Wanarut/Dust_IO/image/184261771_143745554332713_2939920048003660011_n.jpg

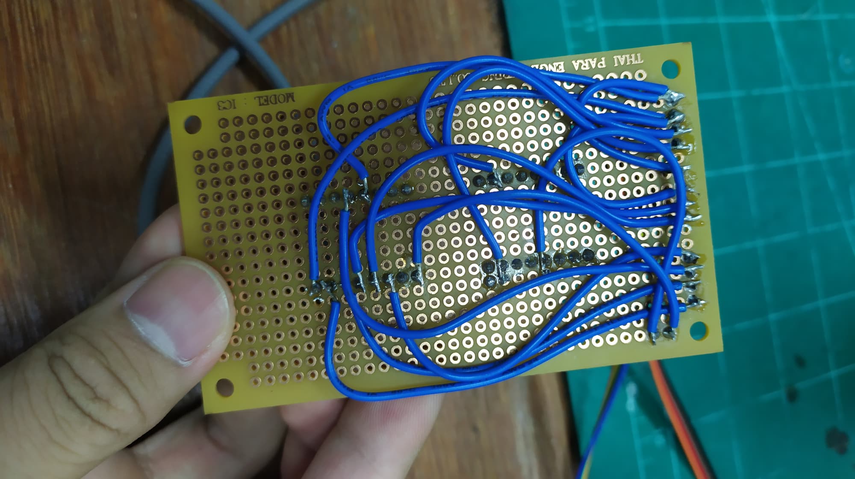
image/184261771_143745554332713_2939920048003660011_n.jpg
