Wanarut/Dust_IO/image/184985335_159320562802014_2121507055169097762_n.jpg

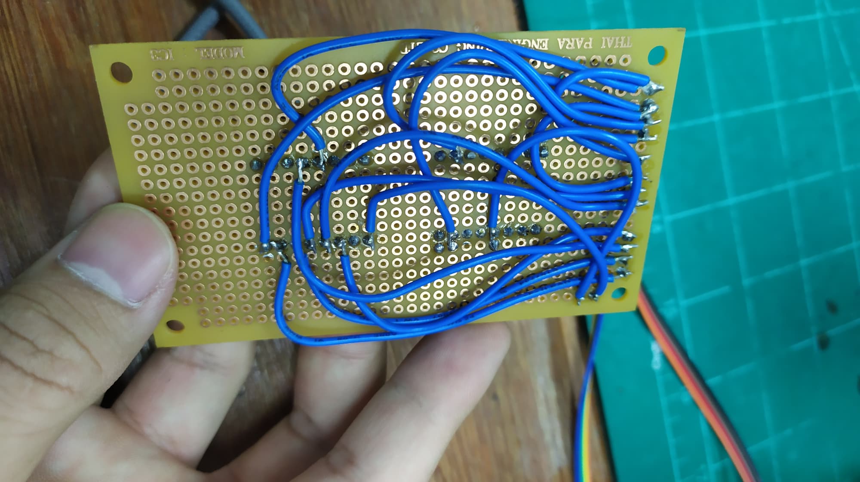
image/184985335_159320562802014_2121507055169097762_n.jpg
