Wanarut/Dust_IO/Screen.pdf

# Screen

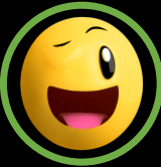
[picture p3: figure]

MODE AUTO H Filter 9 % | 25oc | RH 75%

## PM2.5 12 μg/m3

หน้าหลัก
- วงสีเขียวและอิโมจิเปลี่ยนตามค่าฝุ่ นตาม Slide 8
- ไฟแดงแสดงเมื่อ Filter < 10 %แ

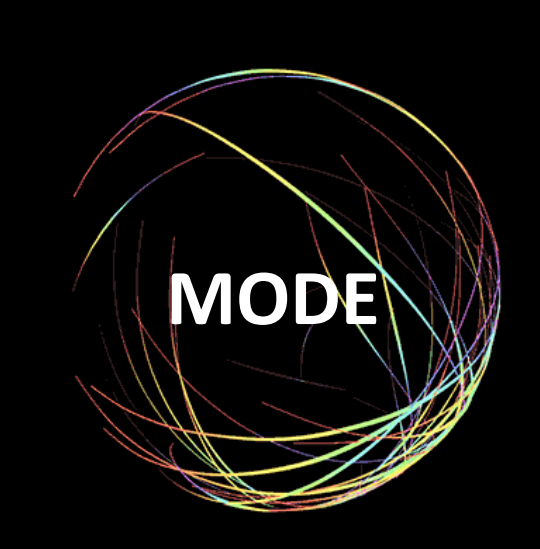
[picture p4: figure]
MODE
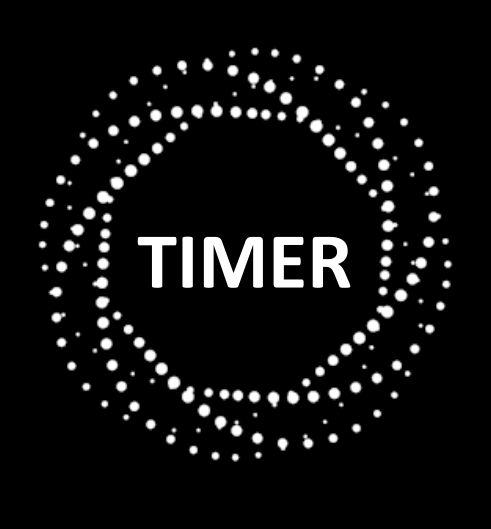
[picture p5: figure]
TIMER

- แตะหน้าหลัก เพื่อเข้าหน้าเลือก MODE,TIMER
- ทุกหน้าหากไม่มีการสั่งการ 15 sec จะกลับไปหน้าหลักอัตโนมัติ

# Screen

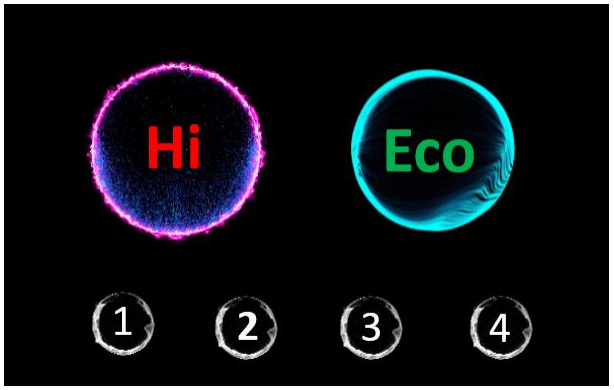
[picture p6: figure]

หน้า MODE
- Hi โหมดเดินเครื่องเต็มก าลังอัตโนมัติ
- eCo โหมดเดินเครื่องเสียงเบาอัตโนมัติ + ประหยัดไฟ
- 1, 2, 3, 4 โหมดปรับความเร็วลมได้ 4 ระดับ

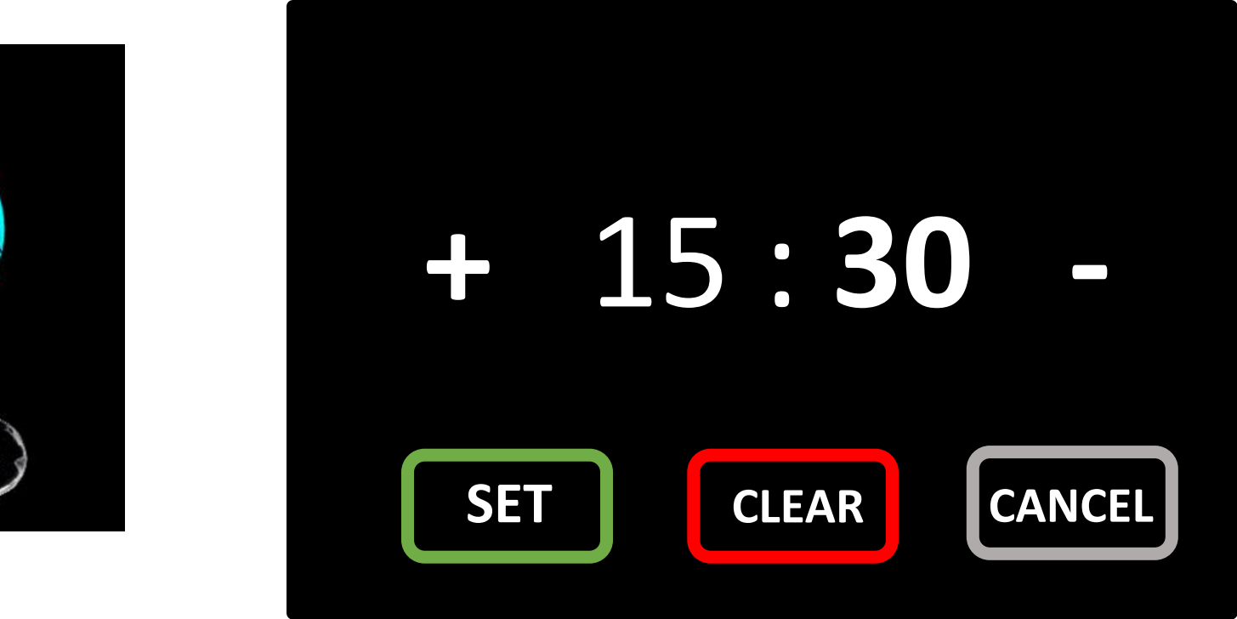
[picture p7: figure]
SET; CLEAR; CANCEL 4

หน้า TIMER
- ตั้งเวลา + , - ครั้งละ 30 min
- SET ตั้งค่าใหม่, CLEAR ลบการตั้งค่าทั้งหมด, CANCLE กลับไปหน้าหลัก

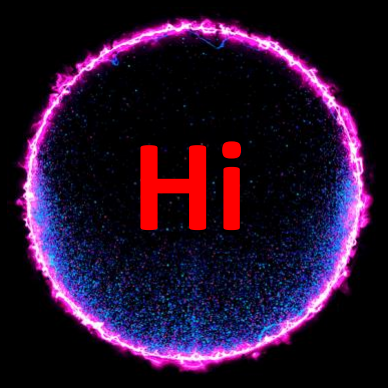
[picture p8: figure]
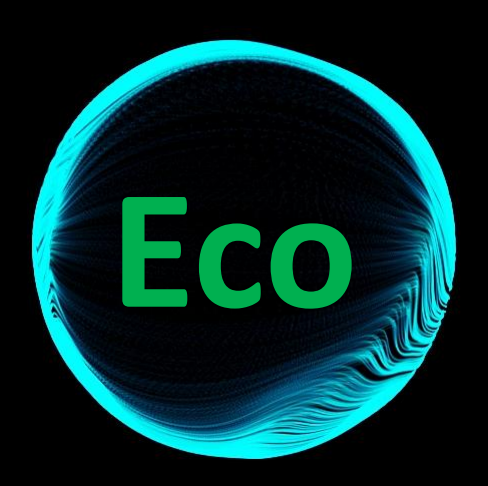
[picture p9: figure]

1 | 2 | 3 | 4
Hi | Eco

# Screen

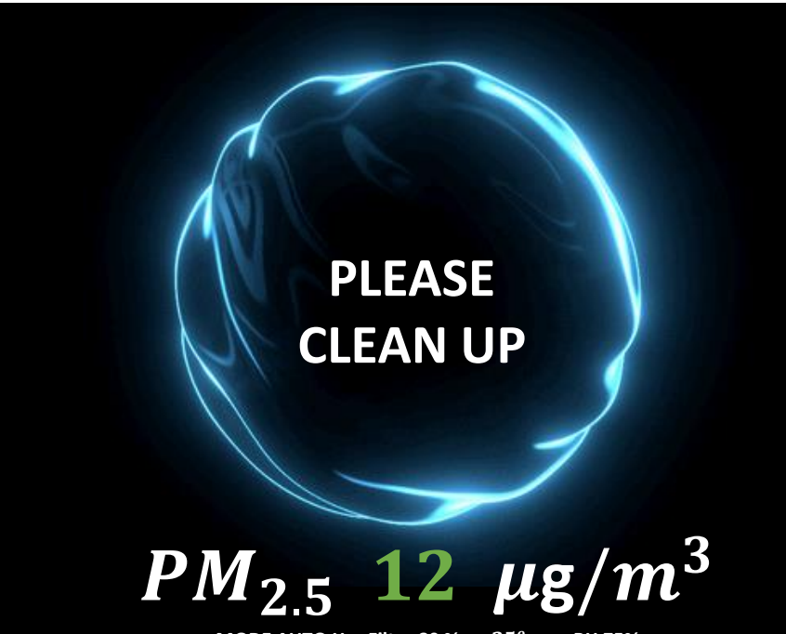
[picture p10: figure]
PLEASE CLEAN UP

หน้าแจ้งเตือนท าความสะอาด ESP

MODE AUTO H Filter 80 % | 25oc | RH 75%

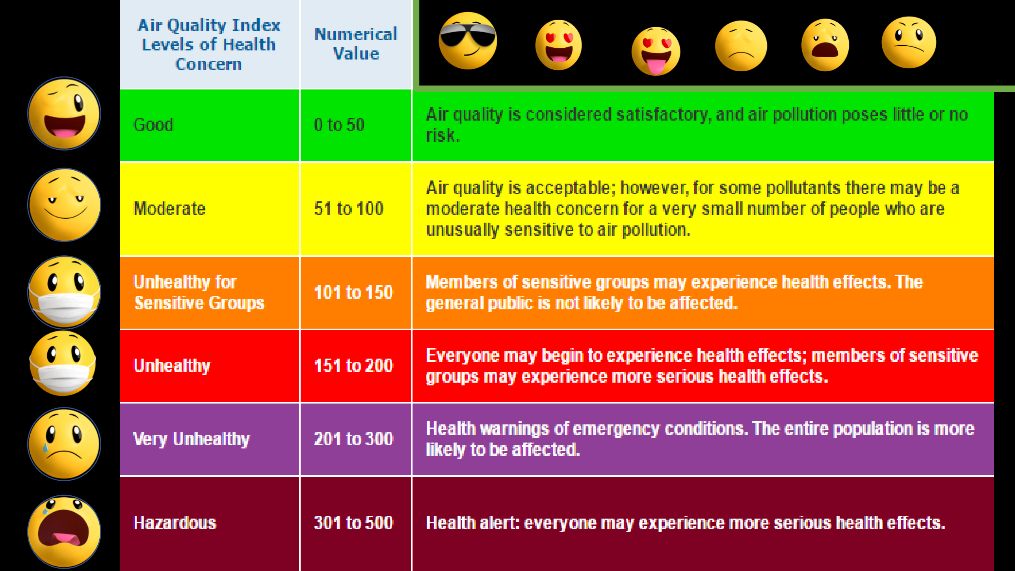
[picture p11: page 5]
