Wanarut/Dust_IO/DustUI/data/1.png

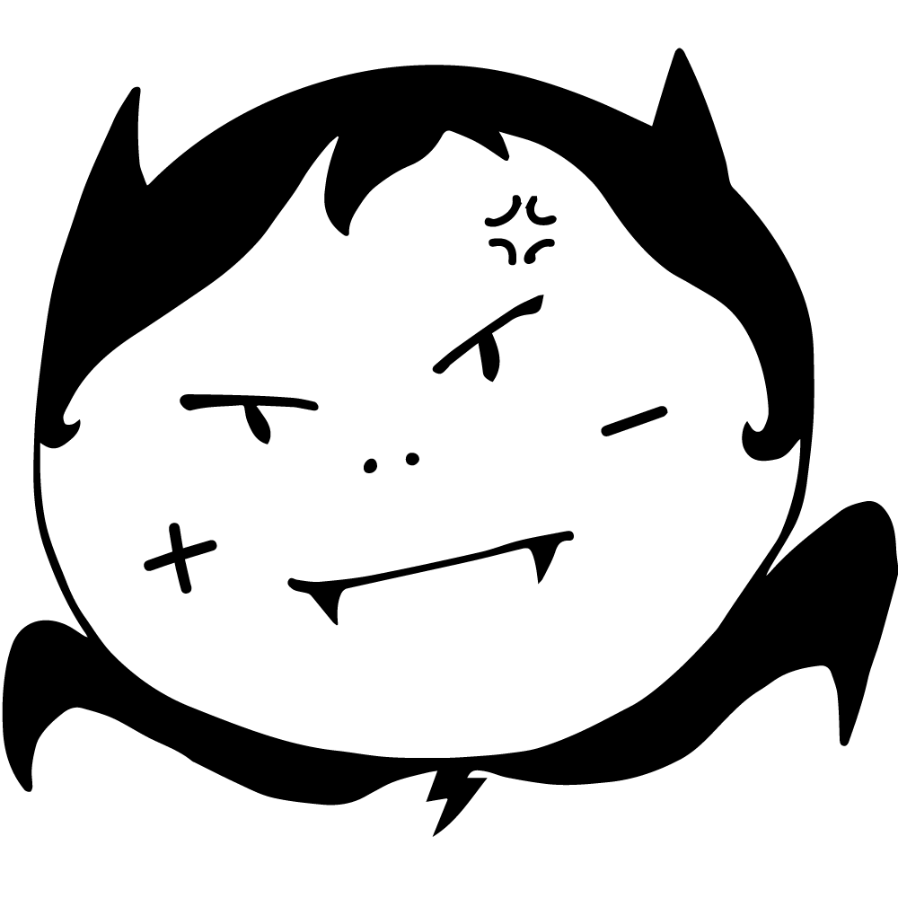
DustUI/data/1.png
