Wanarut/Dust_IO/DustUI/data/2.png

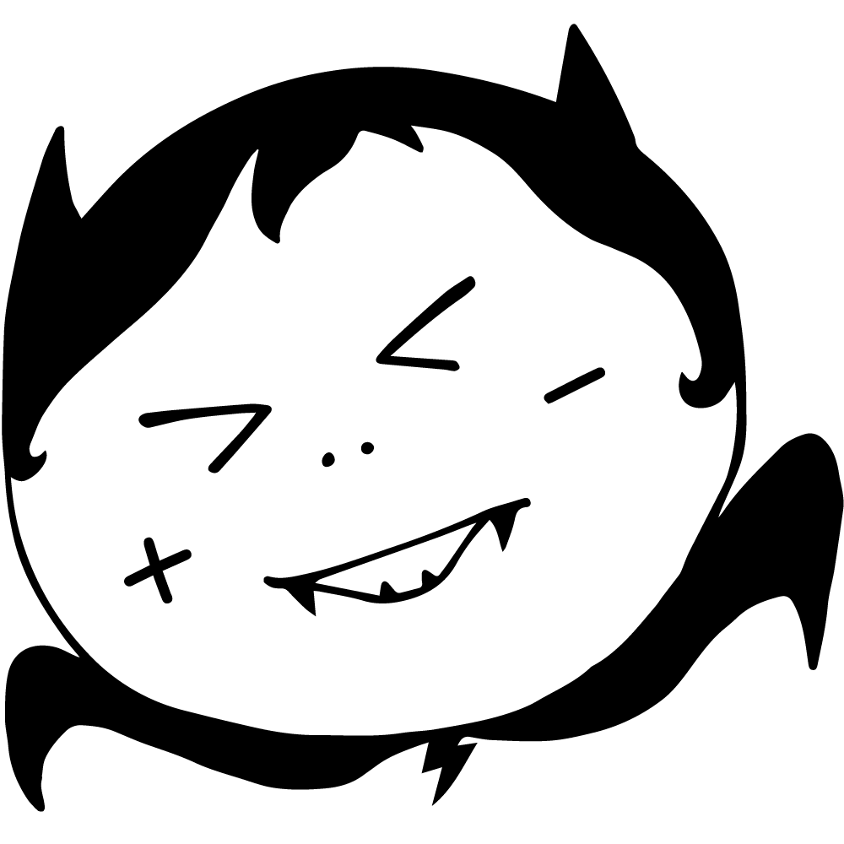
DustUI/data/2.png
