Wanarut/Dust_IO/DustUI/data/4.png

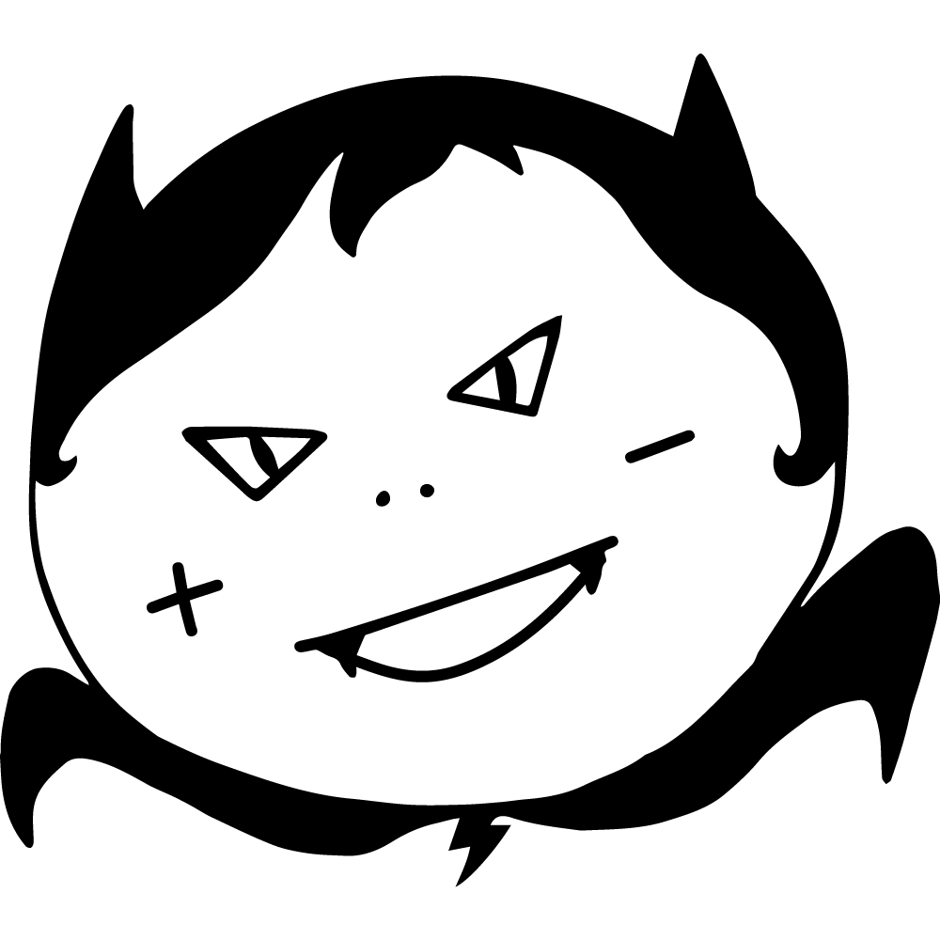
DustUI/data/4.png
