Wanarut/Dust_IO/DustUI/data/5.png

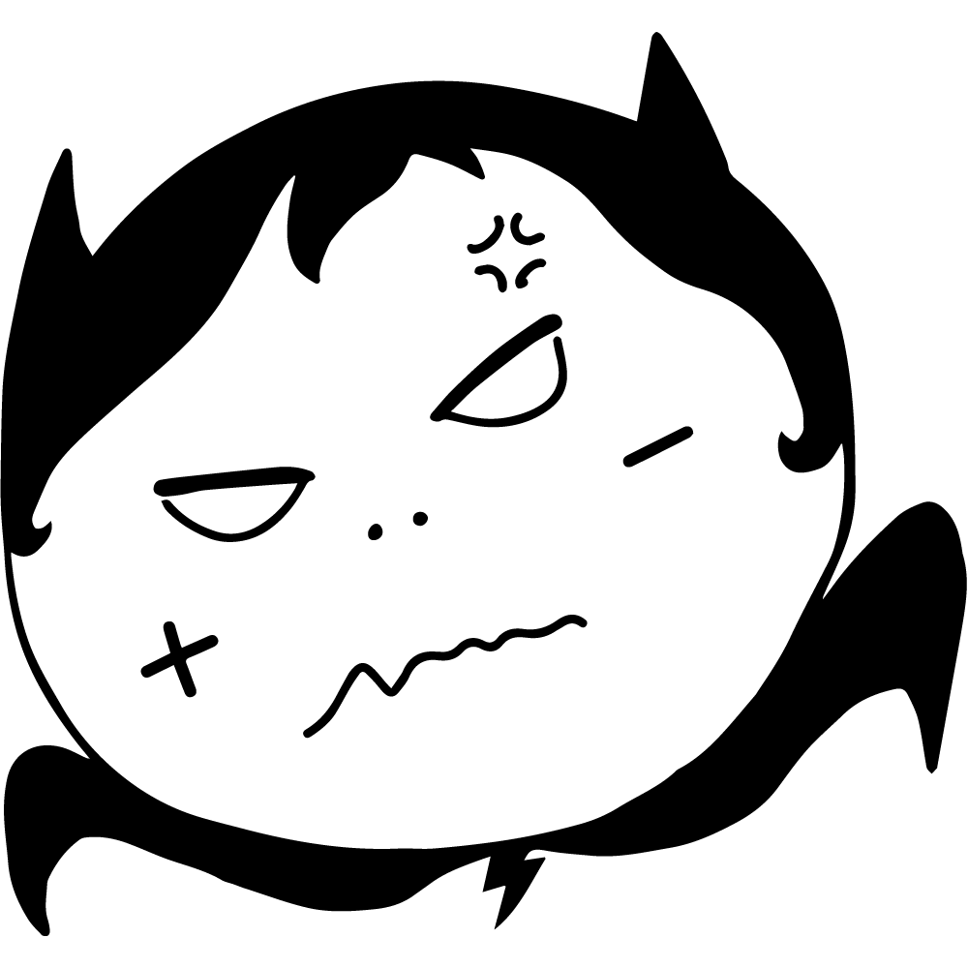
DustUI/data/5.png
