Wanarut/Dust_IO/image/184621561_812715559659490_7830129616699829053_n.jpg

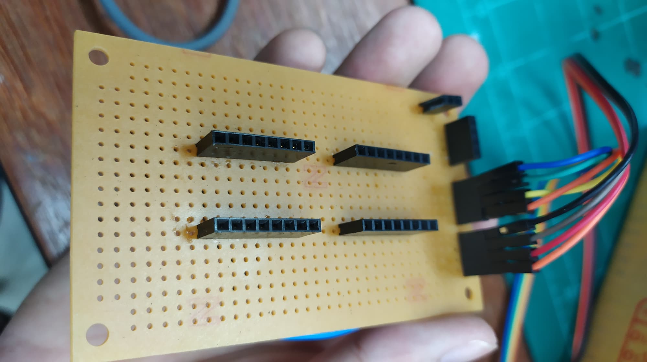
image/184621561_812715559659490_7830129616699829053_n.jpg
