Wanarut/Dust_IO/image/185405579_272317781271764_3399417222174324175_n.jpg

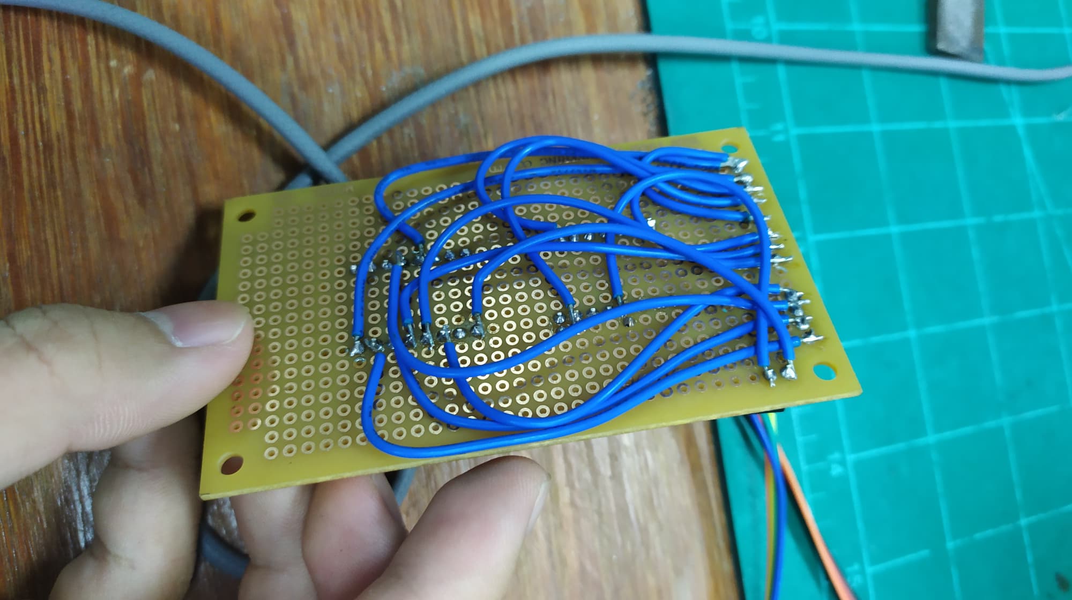
image/185405579_272317781271764_3399417222174324175_n.jpg
