Wanarut/Dust_IO/image/185506124_813041666297395_918857344637462767_n.jpg

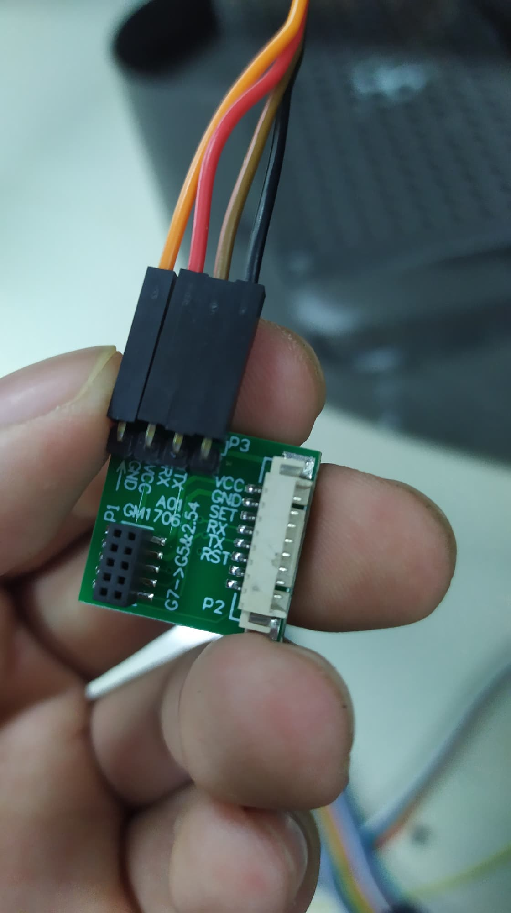
image/185506124_813041666297395_918857344637462767_n.jpg
