Wanarut/Dust_IO/image/Dust Sketch_bb.png

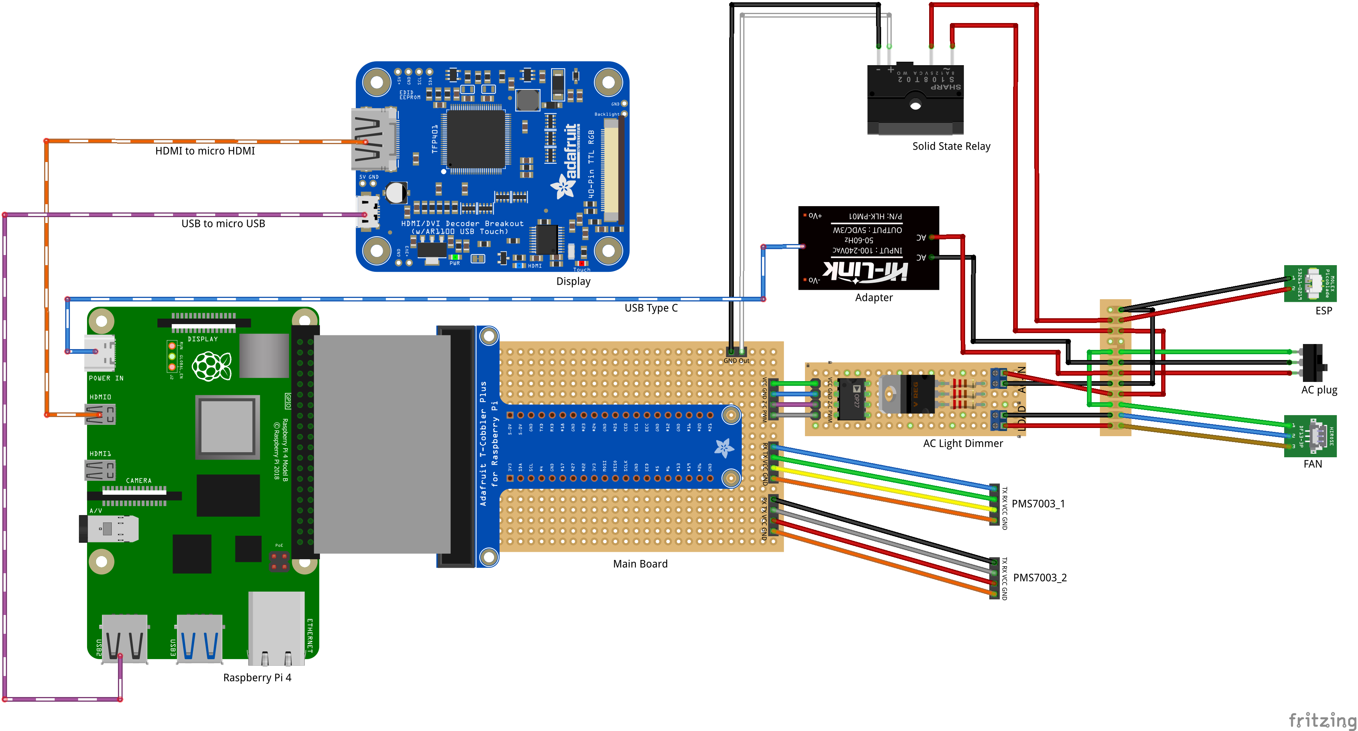
image/Dust Sketch_bb.png
