Wanarut/Dust_IO/TouchDust/data/btn/blue.gif

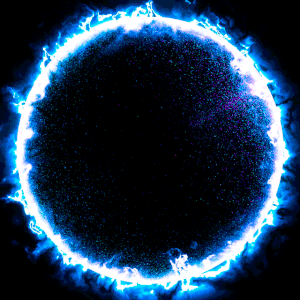
TouchDust/data/btn/blue.gif
