Wanarut/Dust_IO/TouchDust/data/btn/original/purple.gif

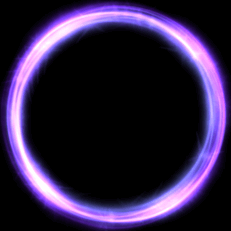
TouchDust/data/btn/original/purple.gif
