Wanarut/Dust_IO/TouchDust/data/btn/original/white.gif

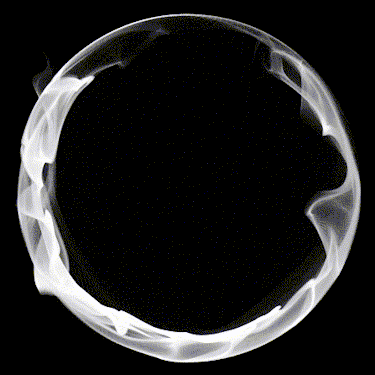
TouchDust/data/btn/original/white.gif
