Wanarut/Dust_IO/TouchDust/data/btn/winkle.gif

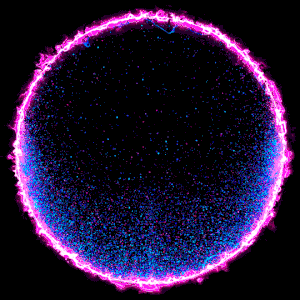
TouchDust/data/btn/winkle.gif
