Wanarut/Dust_IO/TouchDust/data/Emoji/Emoji_1.png

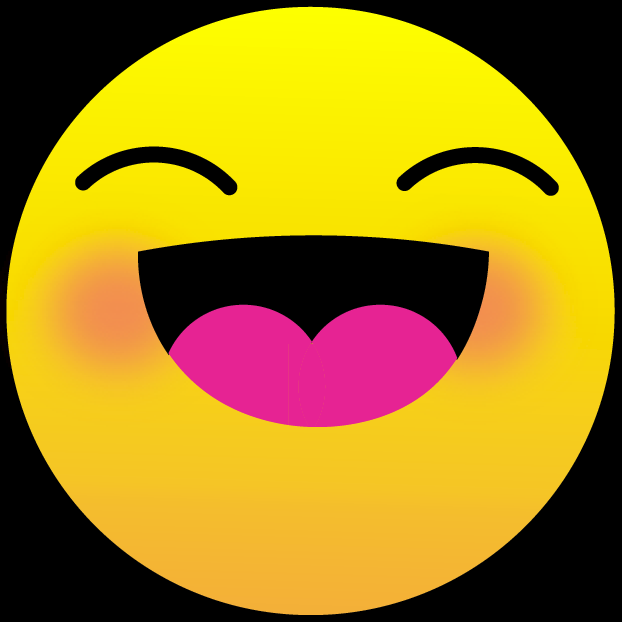
TouchDust/data/Emoji/Emoji_1.png
