Wanarut/Dust_IO/TouchDust/data/Emoji/Emoji_2.png

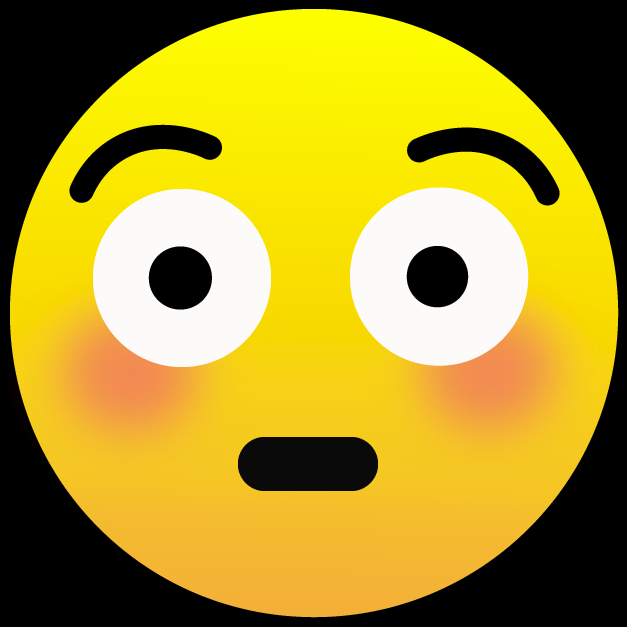
TouchDust/data/Emoji/Emoji_2.png
