Wanarut/Dust_IO/TouchDust/data/Emoji/Emoji_3.png

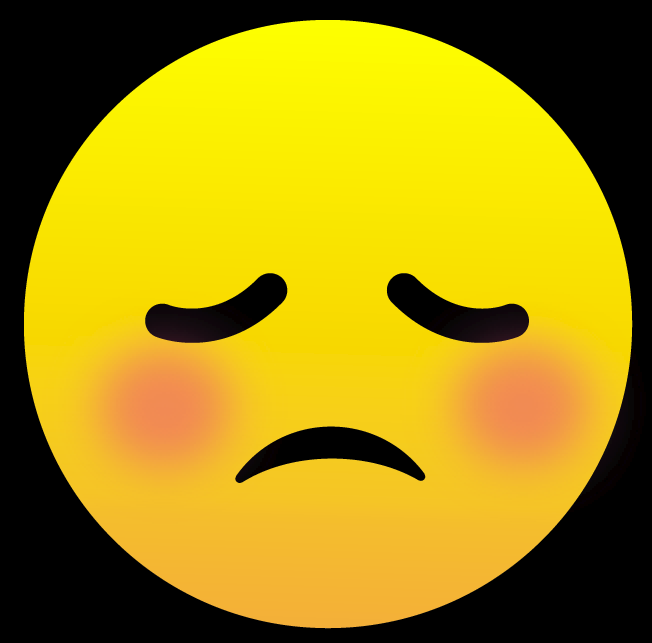
TouchDust/data/Emoji/Emoji_3.png
