Wanarut/Dust_IO/TouchDust/data/Emoji/Emoji_5.png

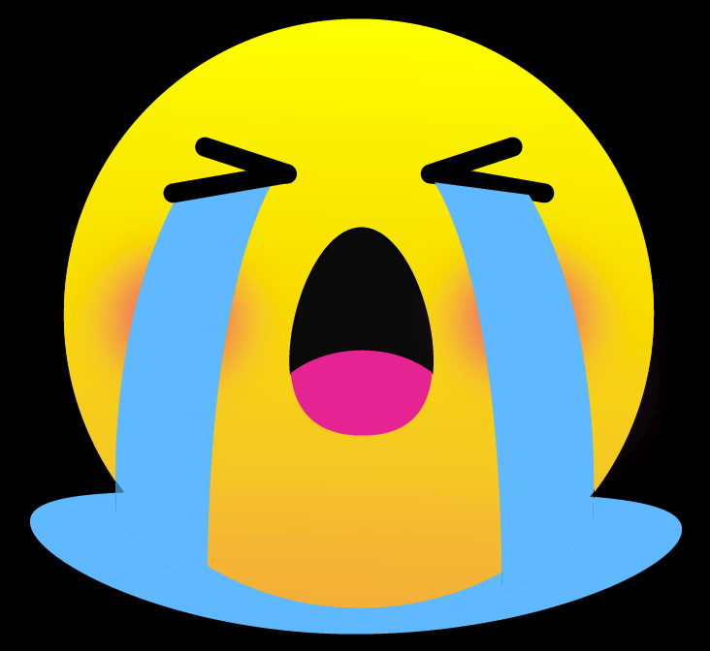
TouchDust/data/Emoji/Emoji_5.png
