Wanarut/Dust_IO/TouchDust/data/Emoji/face-yellow-loop-02.gif

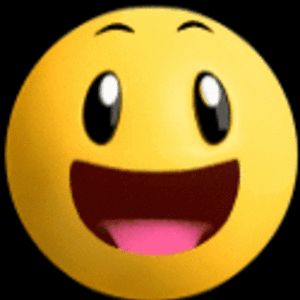
TouchDust/data/Emoji/face-yellow-loop-02.gif
