Wanarut/Dust_IO/TouchDust/data/Emoji/face-yellow-loop-34.gif

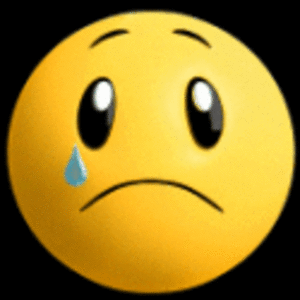
TouchDust/data/Emoji/face-yellow-loop-34.gif
