Wanarut/Dust_IO/TouchDust/data/Emoji/face-yellow-loop-35.gif

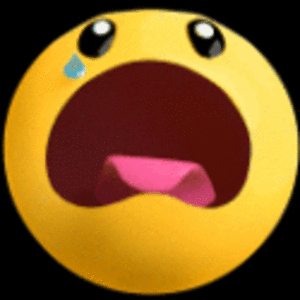
TouchDust/data/Emoji/face-yellow-loop-35.gif
