Wanarut/Dust_IO/TouchDust/data/Emoji/face-yellow-loop-36.gif

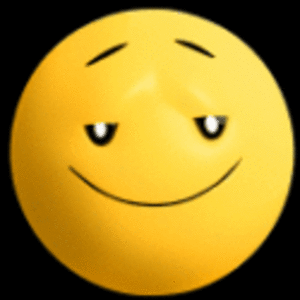
TouchDust/data/Emoji/face-yellow-loop-36.gif
