Wanarut/Dust_IO/TouchDust/data/Emoji/face-yellow-loop-SAd.gif

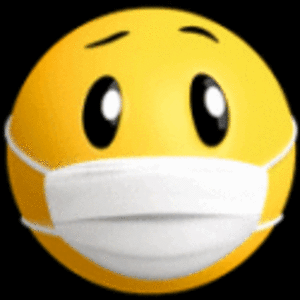
TouchDust/data/Emoji/face-yellow-loop-SAd.gif
