Wanarut/Dust_IO/Control/slider-parts.png

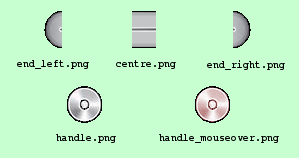
Control/slider-parts.png
