Wanarut/Dust_IO/(list of files, drawings)

Other design files:
Dust Sketch.fzz
