Wanarut/Dust_IO/(commit log)

2021-01-30 test sensor
2021-03-01 init pwm
2021-03-01 servo instead
2021-03-05 pass pwm
2021-03-05 case sen
2021-03-08 add int pin
2021-03-11 can switch screen
2021-03-24 change pwm style
2021-03-25 finish fan control
2021-05-13 test 2 pwm technique
2021-06-15 del pwm + change emoji
